achuwilson/roll_finger/Core/Src/ws2812_led.h

/*
 * Copyright (c) 2020, evilwombat
 *
 * Based on principles described by Martin Hubáček in:
 *  http://www.martinhubacek.cz/arm/improved-stm32-ws2812b-library
 *
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
 */

#pragma once
#include <stdint.h>
#include "stm32f1xx_hal.h"

/*
 * Structure definition for one channel (one LED strip).
 * Provide a pointer to your pixel data, and a length (in bytes, not in pixels)
 * Setting length=0 disables the channel.
 */
struct led_channel_info {
    const uint8_t *framebuffer;
    int length;
};

/* We assume Timer2 runs at 72MHz (the maximum). If yours runs at a different rate, set it here. */
#define TIMER2_FREQ_HZ          56000000

/* Calculate TIM2 period, CH1 pulse width, and CH2 pulse width to be 1.25uS, 0.4uS, and 0.8uS */
#define WS2812_TIMER_PERIOD        (((TIMER2_FREQ_HZ / 1000) * 125) / 100000)
#define WS2812_TIMER_PWM_CH1_TIME  (((TIMER2_FREQ_HZ / 1000) *  40) / 100000)
#define WS2812_TIMER_PWM_CH2_TIME  (((TIMER2_FREQ_HZ / 1000) *  80) / 100000)

/* How many channels (strips) of LEDs we want to control. This must not exceed 16. */
#define WS2812_NUM_CHANNELS     2

/* If all your channel framebuffers are the same size (ie, if each channel has the same number
 * of pixels), you can set this to 1 to bypass some error checking. This will speed things up
 * substantially, potentially allowing you to slow down your CPU and still meet the WS2812
 * timing requirements. "If unsure, set this to 0".
 */
#define WS212_ALL_CHANNELS_SAME_LENGTH  0

/*
 * We support up to 16 LED channels (that is, up to 16 distinct strips of LEDs.
 * Channels must be used sequentially, but their GPIOs do not have to be sequential.
 * Although all the LED strips must be on the same GPIO bank, the channel number does not
 * necessarily have to match its GPIO number. This is useful if we want fewer than 16 channels,
 * but we don't want them to start from GPIO 0.
 *
 * Change these assignments based on which strip you are wiring to which GPIO.
 *
 * To change the GPIO associated with each channel, modify the code below:
 */
#define WS2812_CH0_GPIO      0
#define WS2812_CH1_GPIO      1
#define WS2812_CH2_GPIO      2
#define WS2812_CH3_GPIO      3
#define WS2812_CH4_GPIO      4
#define WS2812_CH5_GPIO      5
#define WS2812_CH6_GPIO      6
#define WS2812_CH7_GPIO      7
#define WS2812_CH8_GPIO      8
#define WS2812_CH9_GPIO      9
#define WS2812_CH10_GPIO    10
#define WS2812_CH11_GPIO    11
#define WS2812_CH12_GPIO    12
#define WS2812_CH13_GPIO    13
#define WS2812_CH14_GPIO    14
#define WS2812_CH15_GPIO    15
/* (These need to be constants at compile-time because they are used in inline ASM) */

void ws2812_init();
void ws2812_refresh(const struct led_channel_info *channels, GPIO_TypeDef *gpio_bank);
