achuwilson/roll_finger/(commit log)

2021-02-07 ALL ADC WORKING
2021-02-09 freertos and timer
2021-02-11 tasks and timers
2021-02-11 PWM on portB, TIM4
2021-02-11 PWM on portA, Pin8, TIM1
2021-02-14 serial interrupt receive
2021-02-15 velocity control of l&f fingers
2021-02-15 gripper open close velocity control
2021-02-16 pwm brake
2021-02-16 lfinger pid pos ctrl
2021-02-16 pid position control of rfinger
2021-02-16 rename stop to brake function
2021-02-17 brake function update
2021-02-17 brake function update2
2021-02-17 brake gripper function
2021-02-17 stop gripper function
2021-02-17 stop finger function
2021-02-17 gripper brake bugfix
2021-02-17 serial Reset Command and serialRxBuffer clear fix
    [main.c]
2021-02-18 rename gripper open-close functions
2021-02-20 gripper close and open basic
2021-02-20 replaced HAL_Delay with osDelay
    [main.c]
2021-02-20 timeout for close position velocity
2021-02-21 add start and end characters, remove \r carriage return
2021-03-31 working code, full uart command input
2021-03-31 LL UART code tested
2021-04-01 add wiring
2021-04-06 gripper gap control
